beatonma/whammy-arduino/wiring-diagram.png

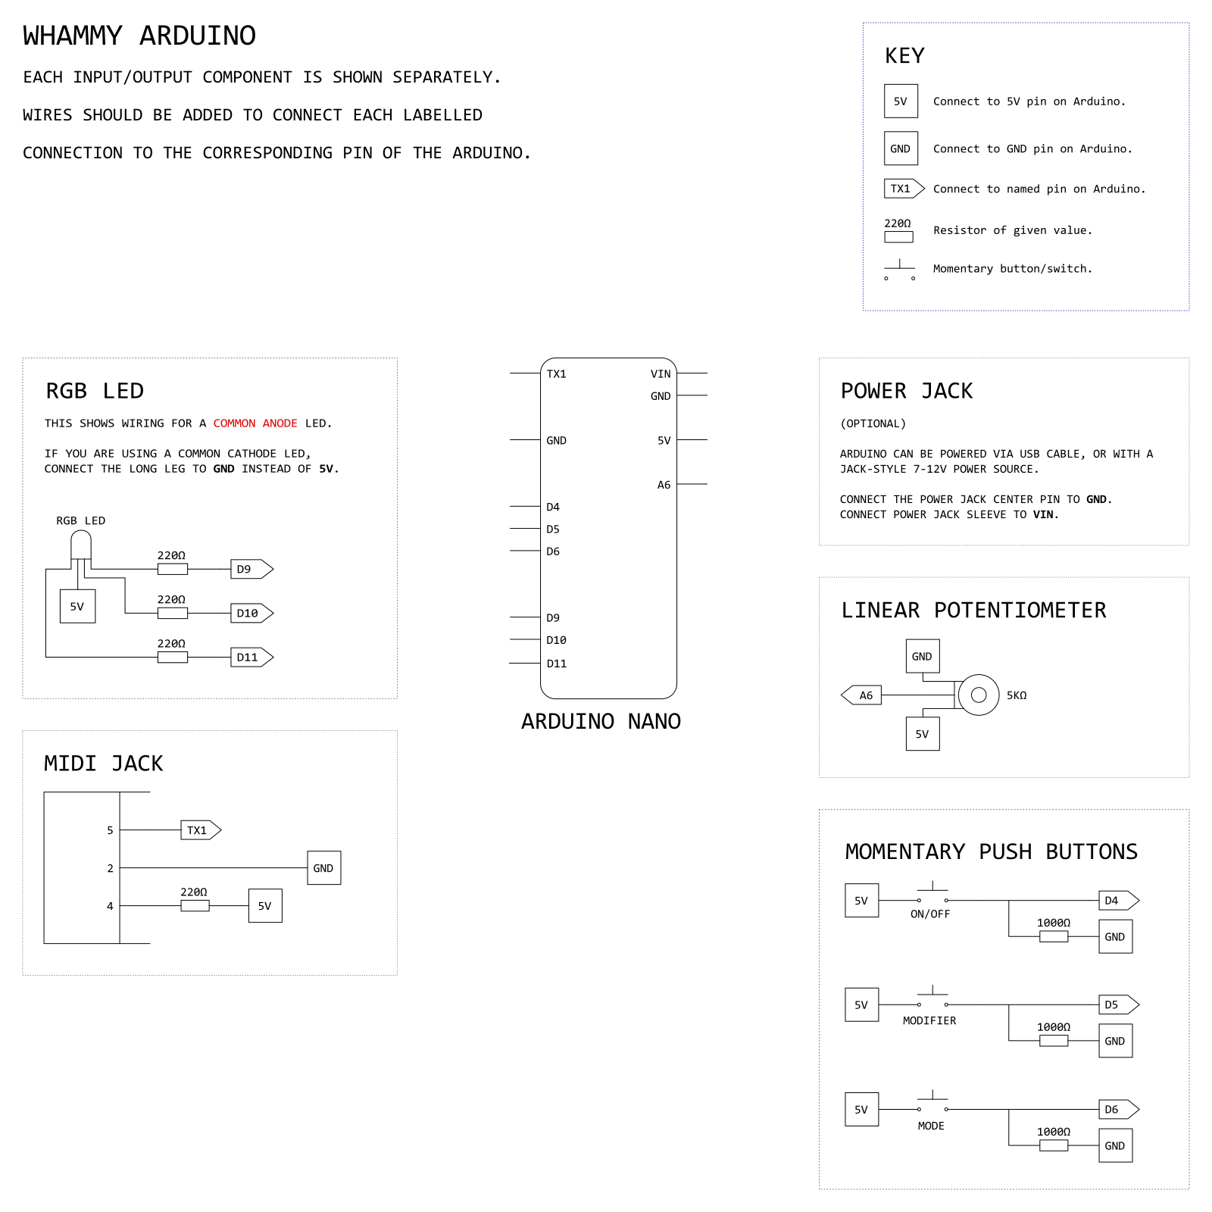
wiring-diagram.png
