beatonma/whammy-arduino/src/led/led.cpp

#include <Arduino.h>
#include "../../config.h"
#include "./led.h"

namespace LED {
  namespace {
    int currentBrightness = MAX_BRIGHTNESS;
    double _normalizedBrightness = 0.5;
    double _red = 0.0;
    double _green = 0.0;
    double _blue = 0.0;

    void setRgb(double r, double g, double b) {
      _red = r;
      _green = g;
      _blue = b;
    }

    double normalize(int value) {
      if (LED_COMMON_PIN == LED_COMMON_ANODE) {
        return (double) value / 255.0;
      }
      else if (LED_COMMON_PIN == LED_COMMON_CATHODE) {
        return 1.0 - ((double) value / 255.0);
      }

      // Invalid config
      return 0.5;
    }

    void write() {
      _normalizedBrightness = normalize(currentBrightness);
      analogWrite(PIN_LED_RED, (int) (_red * _normalizedBrightness));
      analogWrite(PIN_LED_GREEN, (int) (_green * _normalizedBrightness));
      analogWrite(PIN_LED_BLUE, (int) (_blue * _normalizedBrightness));
    }

    void flash() {
      on();
      write();
      delay(200);
      off();
    }
  }

  void setup() {
    pinMode(PIN_LED_RED, OUTPUT);
    pinMode(PIN_LED_GREEN, OUTPUT);
    pinMode(PIN_LED_BLUE, OUTPUT);

    red();
    flash();

    green();
    flash();

    blue();
    flash();
  }

  void setBrightness(uint8_t brightness) {
    currentBrightness = max(0, min(brightness, MAX_BRIGHTNESS));
    write();
  }

  void set(bool _on) {
    if (_on) {
      on();
    }
    else {
      off();
    }
  }

  void off() {
    setBrightness(0);
  }

  void on() {
    setBrightness(MAX_BRIGHTNESS);
  }

  void fade() {
    fadeBy(10);
  }

  void fadeBy(int amount) {
    setBrightness(currentBrightness - amount);
  }

  void red() {
    setRgb(255.0, 0.0, 0.0);

  }
  void green() {
    setRgb(0.0, 255.0, 0.0);
  }

  void blue() {
    setRgb(0.0, 0.0, 255.0);
  }

  void yellow() {
    setRgb(255.0, 255.0, 0.0);
  }

  void cyan() {
    setRgb(0.0, 255.0, 255.0);
  }

  void magenta() {
    setRgb(255.0, 0.0, 255.0);
  }

  void white() {
    setRgb(255.0, 255.0, 255.0);
  }
}
