beatonma/whammy-arduino/src/pedal/pedal.h

#ifndef H_PEDAL
#define H_PEDAL

#include "./midi.h"
#include "./patches.h"

#define POSITION_SEMITONE 127.0 / 12.0
#define semitones(N) (POSITION_SEMITONE * (double) N)

const double POSITION_NULL = -1;
const double POSITION_ROOT = 0.0;
const double POSITION_MINOR_SECOND = semitones(1);
const double POSITION_MAJOR_SECOND = semitones(2);
const double POSITION_MINOR_THIRD = semitones(3);
const double POSITION_MAJOR_THIRD = semitones(4);
const double POSITION_PERFECT_FOURTH = semitones(5);
const double POSITION_TRITONE = semitones(6);
const double POSITION_PERFECT_FIFTH = semitones(7);
const double POSITION_MINOR_SIXTH = semitones(8);
const double POSITION_MAJOR_SIXTH = semitones(9);
const double POSITION_MINOR_SEVENTH = semitones(10);
const double POSITION_MAJOR_SEVENTH = semitones(11);
const double POSITION_OCTAVE = semitones(12);

const double QUANTIZED_POSITIONS[] = {
  POSITION_ROOT,
  POSITION_MINOR_SECOND,
  POSITION_MAJOR_SECOND,
  POSITION_MINOR_THIRD,
  POSITION_MAJOR_THIRD,
  POSITION_PERFECT_FOURTH,
  POSITION_TRITONE,
  POSITION_PERFECT_FIFTH,
  POSITION_MINOR_SIXTH,
  POSITION_MAJOR_SIXTH,
  POSITION_MINOR_SEVENTH,
  POSITION_MAJOR_SEVENTH,
  POSITION_OCTAVE,
};
const uint8_t NUM_QUANTIZED_POSITIONS = 13;


namespace Pedal {
  void setPatch(uint8_t patchID);
  void setPosition(double position);
  void setMaxPosition(double max);
  void on();
  void coerceOn(); // Turn on if not already on.
  void off();
  
  uint8_t getPatch();
  double getPosition();
  double getMaxPosition();

  void setActive(bool active);
  bool getActive();

  /**
   * Send the current patch and position to the actual pedal.
   */
  void apply();

  uint8_t anyPatch();
  double anyPosition();
  double anyQuantizedPosition();
}

#endif
