beatonma/whammy-arduino/(commit log)

2022-04-17 Buttons and potentiometer are all working. On/off button works, mode button works, tempo potentiometer works as proof of concept... Modifier button is not implemented and currently works as on/off.
2022-04-19 Implemented more randomiser modes. Implemented pedal position max limit via modifier button with tempo potentiometer. Can now go to previous mode using modifier button with mode button.
2022-04-19 Fixed sawDown tempo bug.
    [patches.h]
2022-04-20 Implemented stuttering in chaos modes. On/off button can now be momentary or latching: momentary by default; can be changed by pressing it while modifier button is held.
2022-04-20 Implemented 'Scales' mode which chooses quantized pedal positions based on a mode (phyrigian, etc). Tap the modifier button to cycle through modes Ionian...Locrian.
2022-04-21 Sequencer changes.
    Upgraded sequencer to 64 steps.
    Replaced MODE_SQUARE and MODE_MOTP with MODE_SEQUENCER.
    - Cycle through sequences by tapping modifier button.
    monitor.pd: Added optional audiation of patch selection to help with octave sequencing.
    [whammy.ino]
2022-04-21 Bug fixes and tweaks.
    Sequencer length is no longer fixed to 64 steps (64 is still the max though).
    Added octaves and quantized random sequencers.
    Clock now resets so that pedal activation time is t=0 - sequences start
    at the beginning, tempo pulses easier to predict.
    Fixed bug that made it impossible to bypass/turn off the whammy when
    sequencing.
    [config.h, patches.h, pedal.cpp, pedal.h]
2022-04-22 Replaced #define with const values
    [pedal.h]
2022-05-03 Updated wiring config
2022-05-03 Configured for RGB led (previously used single color led)..
2022-05-03 Assigned LED colors to modes. Sawtooth and continuous (sine, triangle) modes replaced with 'waves' mode with subtype selected via modifier button.
    [led.cpp]
2022-05-04 Fixed blue LED - pin 7 does not support PWM, moved to pin 5.
    [config.h]
2022-05-04 Update README for version 1.0.
    Updated modes list, photos, single-color LED to RGB LED.
2023-03-26 Added wiring diagram and updated config.h to match the same configuration.
2023-03-26 Update README.md
    Added link to wiring diagram.
2023-03-27 Added missing resistors to switch GND connections.
    Also minor layout fixes.
2023-03-27 Minor layout tweaks. Added png render in case of differences with fonts or whatever.
2024-11-30 Renamed main `ino` file to match repository name so that default `git clone` creates matching directory name.
    Arduino IDE complains if the file has a different name to the directory it's in.
2024-11-30 Added midi configuration for Whammy DT hardware.
    To use it, edit `config.h` to replace `#define PEDAL_HARDWARE WHAMMY_IV` with `#define PEDAL_HARDWARE WHAMMY_DT`
    [config.h, patches.h]
2025-01-18 Fixed resistor values for buttons 220 ohm -> 1000 ohm. Renamed 'Switches' section to 'Momentary push buttons' for clarity. Fixed minor type.
2025-03-22 Added `LED_COMMON_PIN` config value and logic to handle common cathode/common anode LEDs
